ItsReckliss/MycoLogger/hardware/transmitter/manufacturing/BOM_MycoLogger V0.3_MycoLogger V0.3.xlsx

No. | Quantity | Comment | Designator | Footprint | Value | Manufacturer Part | Manufacturer | Supplier Part | Supplier
1 | 2 | 1uF | C1,C3 | C0201 | 1uF
2 | 5 | 4.7uF | C2,C4,C5,C6,C9 | C0402 | 4.7uF
3 | 1 | 220nF | C7 | C0201 | 220nF
4 | 1 | 2.2uF | C8 | C0201 | 2.2uF
5 | 1 | 470pF | C10 | C0201 | 470pF
6 | 2 | 100nF | C11,C12 | C0201 | 100nF
7 | 1 | 10nF | C13 | C0201 | 10nF
8 | 1 | SH1.0mm-4P-WT | CN1 | CONN-SMD_SH1.0MM-4P-WT |  | SH1.0mm-4P-WT | LXWCONN(连兴旺电子) | C53055320 | LCSC
9 | 2 | LED_0402-R | LED1,LED2 | LED0402-RD_YELLOW
10 | 1 | 0 | R1 | R0201 | 0
11 | 1 | 68 | R2 | R0201 | 68
12 | 1 | 2K | R3 | R0201 | 2K
13 | 1 | 150 | R4 | R0201 | 150
14 | 2 | 5.1K | R5,R6 | R0201 | 5.1K
15 | 2 | 10K | R7,R8 | R0201 | 10K
16 | 2 | 470K | R9,R10 | R0201 | 470K
17 | 1 | 1M | R11 | R0201 | 1M
18 | 1 | 10k | R12 | R0201 | 10k
19 | 1 | SSSS811101 | SW1 | SW-SMD_SSSS811101 |  | SSSS811101 | ALPSALPINE(阿尔卑斯阿尔派) | C109335 | LCSC
20 | 1 | G4R152312 | SW2 | SW-SMD_4P-L5.2-W5.2-P3.70-LS6.4_UK-B0233XX |  | G4R152312 | SAMZO(三佐) | C49393646 | LCSC
21 | 1 | MCP1700T-3302E/TT | U1 | SOT-23-3_L2.9-W1.6-P1.90-LS2.8-BR |  | MCP1700T-3302E/TT | MICROCHIP(美国微芯) | C39051 | LCSC
22 | 1 | TPS22918DBVT | U2 | SOT-23-6_L2.9-W1.6-P0.95-LS2.8-BR |  | TPS22918DBVT | TI(德州仪器) | C2680345 | LCSC
23 | 1 | MCP73831T-2ACI/OT (Rev) | U3 | SOT-23-5_L3.0-W1.7-P0.95-LS2.8-BL |  | MCP73831T-2ACI/OT | MICROCHIP(美国微芯) | C424093 | LCSC
24 | 1 | SCD41-D-R2_C3659421 | U4 | LGA-20_L10.1-W10.1-P1.25-TL |  | SCD40-D-R2 | Sensirion(瑞士盛思锐) | C3659421 | LCSC
25 | 1 | 915MHz | U5 | COMM-SMD_LORA1276-C1-915MHZ | 915MHz | lora1276-C1-915MHz | G-NiceRF(思为无线) | C3001531 | LCSC
26 | 1 | STM32U031F6P6 | U6 | TSSOP-20_L6.5-W4.4-P0.65-LS6.4-BL_1
27 | 1 | TYPE-C 16PIN 2MD(073) | USB1 | USB-C-SMD_TYPE-C-16PIN-2MD-073 |  | TYPE-C 16PIN 2MD(073) | SHOU HAN(首韩) | C2765186 | LCSC
