ItsReckliss/MycoLogger/firmware/transmitter/MycoLogger Node/Core/Inc/main.h

#define Debug_Button_Pin GPIO_PIN_14
#define Debug_Button_GPIO_Port GPIOC
#define Debug_LED_Pin GPIO_PIN_3
#define Debug_LED_GPIO_Port GPIOF
#define Radio_MOSI_Pin             GPIO_PIN_8
#define Radio_MOSI_GPIO_Port       GPIOB
#define Radio_BUSY_Pin             GPIO_PIN_1
#define Radio_BUSY_GPIO_Port       GPIOA
#define Radio_NSS_Pin              GPIO_PIN_3
#define Radio_NSS_GPIO_Port        GPIOA
#define Radio_SCK_Pin              GPIO_PIN_5
#define Radio_SCK_GPIO_Port        GPIOA
#define Radio_MISO_Pin             GPIO_PIN_7
#define Radio_MISO_GPIO_Port       GPIOA
#define Radio_DIO1_Pin             GPIO_PIN_1
#define Radio_DIO1_GPIO_Port       GPIOB
#define Radio_REST_Pin             GPIO_PIN_8
#define Radio_REST_GPIO_Port       GPIOA
#define Sensor_Power_Pin           GPIO_PIN_7
#define Sensor_Power_GPIO_Port     GPIOB
#define Sensor_SDA_Pin             GPIO_PIN_11
#define Sensor_SDA_GPIO_Port       GPIOA
#define Sensor_SCL_Pin             GPIO_PIN_12
#define Sensor_SCL_GPIO_Port       GPIOA
