ItsReckliss/MycoLogger/firmware/receiver/MycoReceiver/Core/Inc/app.h

#ifndef APP_H
#define APP_H

/**
 * @brief Initializes the MycoReceiver application.
 */
void App_Init(void);

/**
 * @brief Runs one iteration of the application.
 *
 * This function is called repeatedly from the main loop.
 */
void App_Run(void);

#endif
