ItsReckliss/MycoLogger/tools/read_receiver.py

#!/usr/bin/env python3
"""Read and validate MycoLogger receiver NDJSON from a USB serial port."""

import argparse
import json
import sys
import time
from typing import Optional

try:
    import serial
    from serial.tools import list_ports
except ImportError as exc:
    raise SystemExit(
        "pyserial is required; install it with: python3 -m pip install pyserial"
    ) from exc


MYCOLOGGER_VID = 0x0483
MYCOLOGGER_PID = 0x5740

SCD41_ERRORS = {
    0: "none",
    1: "serial_command_nack",
    2: "serial_read_nack",
    3: "serial_crc",
    4: "single_shot_nack",
    5: "ready_command_nack",
    6: "ready_read_nack",
    7: "ready_crc",
    8: "measurement_timeout",
    9: "measurement_command_nack",
    10: "measurement_read_nack",
    11: "measurement_crc",
    12: "scl_held_low",
    13: "sda_held_low",
    14: "address_nack",
    15: "command_msb_nack",
    16: "command_lsb_nack",
}


def decode_radio_payload(record: dict) -> None:
    """Add a human-readable view of known MycoLogger radio packets."""
    if record.get("type") != "packet":
        return

    payload_hex = record.get("payload_hex")
    if not isinstance(payload_hex, str):
        return

    try:
        payload = bytes.fromhex(payload_hex)
    except ValueError:
        return

    if len(payload) < 19 or payload[:4] != b"MYCO":
        return

    version = payload[4]
    packet_type = payload[5]
    if version != 1 or packet_type not in (1, 2):
        return

    flags = payload[18]
    decoded = {
        "protocol": version,
        "packet_type": "link_test" if packet_type == 1 else "sensor_reading",
        "node_id": int.from_bytes(payload[6:10], "big"),
        "tx_sequence": int.from_bytes(payload[10:14], "big"),
        "tx_uptime_s": int.from_bytes(payload[14:18], "big"),
        "button_pressed": bool(flags & 0x01),
    }

    if packet_type == 2 and len(payload) >= 25:
        sensor_valid = bool(flags & 0x02)
        decoded["sensor_valid"] = sensor_valid
        if sensor_valid:
            decoded["co2_ppm"] = int.from_bytes(payload[19:21], "big")
            decoded["temperature_c"] = (
                int.from_bytes(payload[21:23], "big", signed=True) / 100.0
            )
            decoded["humidity_percent"] = (
                int.from_bytes(payload[23:25], "big") / 100.0
            )
        if len(payload) >= 26:
            error_code = payload[25]
            decoded["sensor_error"] = SCD41_ERRORS.get(
                error_code, f"unknown_{error_code}"
            )
        if len(payload) >= 39:
            decoded["firmware_version"] = (
                f"{payload[36]}.{payload[37]}.{payload[38]}"
            )
        if len(payload) >= 47:
            decoded["reset_flags"] = int.from_bytes(payload[39:43], "big")
            decoded["sensor_failure_count"] = int.from_bytes(payload[43:45], "big")
            decoded["radio_failure_count"] = int.from_bytes(payload[45:47], "big")

    record["decoded"] = decoded


def find_receiver_port(requested_port: Optional[str]) -> Optional[str]:
    """Return an available receiver port, or None while it is disconnected."""
    available_ports = list(list_ports.comports())

    if requested_port is not None:
        requested_casefold = requested_port.casefold()
        for port in available_ports:
            if port.device.casefold() == requested_casefold:
                return port.device
        return None

    # Prefer the custom USB product name when the OS exposes it.
    for port in available_ports:
        identity = " ".join(
            value
            for value in (port.product, port.description, port.manufacturer)
            if value
        ).casefold()
        if "mycologger" in identity:
            return port.device

    # The development firmware still uses Cube's prototype VID/PID.
    for port in available_ports:
        if port.vid == MYCOLOGGER_VID and port.pid == MYCOLOGGER_PID:
            return port.device

    return None


def print_record(raw_line: bytes) -> None:
    """Validate and print one protocol record."""
    try:
        record = json.loads(raw_line.decode("utf-8"))
    except (UnicodeDecodeError, json.JSONDecodeError) as exc:
        print(
            f"Ignored invalid record ({exc}): {raw_line!r}",
            file=sys.stderr,
        )
        return

    if record.get("v") != 1:
        print(
            f"Ignored unsupported protocol version: {record.get('v')!r}",
            file=sys.stderr,
        )
        return

    decode_radio_payload(record)
    print(json.dumps(record, separators=(",", ":")), flush=True)


def main() -> int:
    parser = argparse.ArgumentParser(
        description="Print JSON records received from a MycoLogger receiver"
    )
    parser.add_argument(
        "port",
        nargs="?",
        help=(
            "serial port such as COM4 or /dev/ttyACM0; omit to discover "
            "the receiver automatically"
        ),
    )
    parser.add_argument(
        "--retry-seconds",
        type=float,
        default=0.5,
        help="delay between reconnect attempts (default: 0.5)",
    )
    args = parser.parse_args()

    if args.retry_seconds <= 0:
        parser.error("--retry-seconds must be greater than zero")

    requested_name = args.port or "a MycoLogger receiver"
    waiting_message_shown = False

    while True:
        port_name = find_receiver_port(args.port)
        if port_name is None:
            if not waiting_message_shown:
                print(
                    f"Waiting for {requested_name}; connect the receiver when ready...",
                    file=sys.stderr,
                )
                waiting_message_shown = True
            time.sleep(args.retry_seconds)
            continue

        try:
            with serial.Serial(port_name, 115200, timeout=2) as receiver:
                print(f"Listening on {receiver.port}...", file=sys.stderr)
                waiting_message_shown = False
                receiver.write(b"INFO\n")

                while True:
                    raw_line = receiver.readline()
                    if raw_line:
                        print_record(raw_line)

        except (serial.SerialException, OSError):
            if not waiting_message_shown:
                print(
                    f"Receiver disconnected; waiting for {requested_name}...",
                    file=sys.stderr,
                )
                waiting_message_shown = True
            time.sleep(args.retry_seconds)


if __name__ == "__main__":
    try:
        raise SystemExit(main())
    except KeyboardInterrupt:
        raise SystemExit(0)
