ItsReckliss/MycoLogger/(commit log)

2026-08-12 Build end-to-end MycoLogger prototype
    Add bidirectional LoRa firmware, persistent node provisioning, battery and SCD41 telemetry, the receiver service, grow tracking dashboard, tests, protocol documentation, and hardware source layout.
2026-08-12 Plan transmitter and receiver enclosures
2026-08-12 Plan accessible transmitter programming connector
2026-08-12 Correct transmitter battery ADC channels
    [battery_adc.c, main.c]
2026-08-12 Fix live transmitter battery measurement
    [battery_adc.c, main.c]
2026-08-12 Calibrate transmitter battery voltage
2026-08-13 Add transmitter V0.3 hardware exports
    [BOM_MycoLogger V0.3_MycoLogger V0.3.xlsx, PickAndPlace_MycoLogger V0_3.xlsx]
2026-08-13 Record SCD41 power-cycle comparison
2026-08-13 Verify disabled SCD41 calibration
2026-08-13 Add dashboard battery status alerts
2026-08-13 Refine battery and graph overlays
